LLC536/Laser_dieu_huong_VienVatLy/(commit log)

2026-08-12 Add Arduino motor controller code for laser positioning
2026-08-12 Add laser tracking and control functionality
    Implement laser coordinate detection and control system.
2026-08-12 Add installation and usage instructions for laser system
2026-08-17 Add error tracking for X and Y axes
    [Python_Vision_Master.py]
